amsmith1109/Low-Cost-Pirani-Gauge/Electronics/PCB Rear - Step 1.png

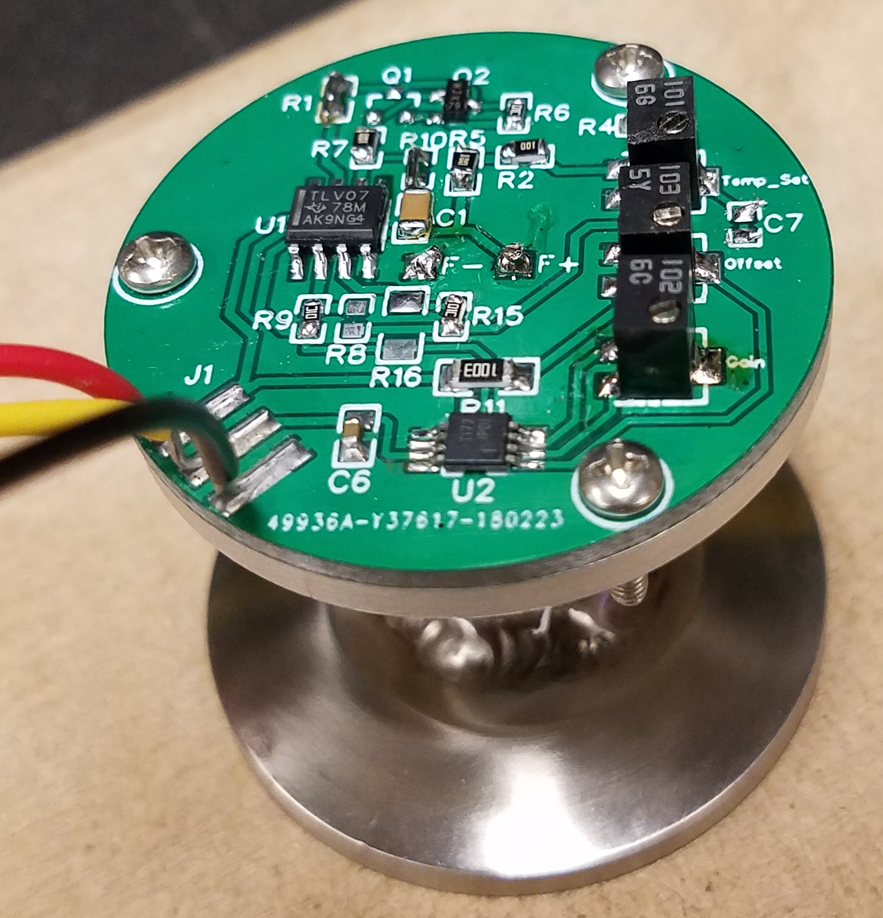
Electronics/PCB Rear - Step 1.png
