amsmith1109/Low-Cost-Pirani-Gauge/(list of files, cad)

Other CAD files:
3D Models (Inventor 2020)/Gauge/#22 o-ring.ipt
3D Models (Inventor 2020)/Gauge/2-56 1-2in length PHS.ipt
3D Models (Inventor 2020)/Gauge/4-40 1-4in length PHS.ipt
3D Models (Inventor 2020)/Gauge/Black 0603.ipt
3D Models (Inventor 2020)/Gauge/Black 0805.ipt
3D Models (Inventor 2020)/Gauge/Black 1206.ipt
3D Models (Inventor 2020)/Gauge/Board Spacer - 2.ipt
3D Models (Inventor 2020)/Gauge/Cap 0603.ipt
3D Models (Inventor 2020)/Gauge/Component1.ipt
3D Models (Inventor 2020)/Gauge/Component5(Mirror).ipt
3D Models (Inventor 2020)/Gauge/Component5.ipt
3D Models (Inventor 2020)/Gauge/Filament - updated.ipt
3D Models (Inventor 2020)/Gauge/Filament Board.iam
3D Models (Inventor 2020)/Gauge/Filament Board.ipt
3D Models (Inventor 2020)/Gauge/Housing - 3,2.ipt
3D Models (Inventor 2020)/Gauge/LED-0603H0.75.ipt
3D Models (Inventor 2020)/Gauge/Pirani Gauge.iam
3D Models (Inventor 2020)/Gauge/Power Supply Board.iam
3D Models (Inventor 2020)/Gauge/Power Supply.ipt
3D Models (Inventor 2020)/Gauge/RJ12 - Straight.ipt
3D Models (Inventor 2020)/Gauge/SM42W.ipt
3D Models (Inventor 2020)/Gauge/SOT-23 (TO-236).ipt
3D Models (Inventor 2020)/Gauge/SOT23.iam
3D Models (Inventor 2020)/Gauge/TO-252AA-Vishay.ipt
3D Models (Inventor 2020)/Gauge/Vacuum Housing - KF.ipt
3D Models (Inventor 2020)/Gauge/aluminumelectrolytic.ipt
3D Models (Inventor 2020)/Gauge/icbody.ipt
3D Models (Inventor 2020)/Gauge/pin.ipt
3D Models (Inventor 2020)/Gauge/sop127p-6mm-8 v2.iam
3D Models (Inventor 2020)/Readout/1 pin header.ipt
3D Models (Inventor 2020)/Readout/10 female pin.ipt
3D Models (Inventor 2020)/Readout/10 pin header.ipt
3D Models (Inventor 2020)/Readout/10_Micro USB-B SMD & pads.ipt
3D Models (Inventor 2020)/Readout/15 female pin.ipt
3D Models (Inventor 2020)/Readout/15 pin header - round.ipt
3D Models (Inventor 2020)/Readout/16 pin header.ipt
3D Models (Inventor 2020)/Readout/2 female pin.ipt
3D Models (Inventor 2020)/Readout/2x3 header.ipt
3D Models (Inventor 2020)/Readout/4 female pin.ipt
3D Models (Inventor 2020)/Readout/400nH Inductor.ipt
3D Models (Inventor 2020)/Readout/4x20 LCD.ipt
3D Models (Inventor 2020)/Readout/ADS1115.ipt
3D Models (Inventor 2020)/Readout/Arduino Nano - Soldered.iam
3D Models (Inventor 2020)/Readout/Arduino Nano.ipt
3D Models (Inventor 2020)/Readout/Black 0603 - Soldered.ipt
3D Models (Inventor 2020)/Readout/Black 0805.ipt
3D Models (Inventor 2020)/Readout/Black 1206 - Soldered.ipt
3D Models (Inventor 2020)/Readout/Boost Converter.iam
3D Models (Inventor 2020)/Readout/Boost Converter.ipt
3D Models (Inventor 2020)/Readout/Cap 0805.ipt
3D Models (Inventor 2020)/Readout/Clicker Switch.ipt
3D Models (Inventor 2020)/Readout/DO-221AC.ipt
3D Models (Inventor 2020)/Readout/Faceplate.ipt
3D Models (Inventor 2020)/Readout/Gauge Controller.iam
3D Models (Inventor 2020)/Readout/LED-0603H0.75 - Soldered.ipt
3D Models (Inventor 2020)/Readout/Male Header - 1X2Wht.ipt
3D Models (Inventor 2020)/Readout/Male Headers.ipt
3D Models (Inventor 2020)/Readout/MicroUSB Breakout.iam
3D Models (Inventor 2020)/Readout/MicroUSB.iam
3D Models (Inventor 2020)/Readout/OldVersions/4x20 LCD.0006.ipt
3D Models (Inventor 2020)/Readout/OldVersions/Base2.0001.ipt
3D Models (Inventor 2020)/Readout/OldVersions/Faceplate.0004.ipt
3D Models (Inventor 2020)/Readout/OldVersions/Faceplate.0028.ipt
3D Models (Inventor 2020)/Readout/OldVersions/Readout Cover.0005.ipt
3D Models (Inventor 2020)/Readout/OldVersions/Readout.0022.iam
3D Models (Inventor 2020)/Readout/PCB.ipt
3D Models (Inventor 2020)/Readout/PHS UNC.ipt
3D Models (Inventor 2020)/Readout/PHS UNC19.ipt
3D Models (Inventor 2020)/Readout/PHS UNC2.ipt
3D Models (Inventor 2020)/Readout/PHS UNC20.ipt
3D Models (Inventor 2020)/Readout/Precision Trim Pot - baoter 3296.ipt
3D Models (Inventor 2020)/Readout/RJ12 - 90deg.ipt
3D Models (Inventor 2020)/Readout/Readout Base.ipt
3D Models (Inventor 2020)/Readout/Readout Cover.ipt
3D Models (Inventor 2020)/Readout/Readout Wires.ipt
3D Models (Inventor 2020)/Readout/Readout.iam
3D Models (Inventor 2020)/Readout/SOT-23 6 pin.iam
3D Models (Inventor 2020)/Readout/SOT323-5L.ipt
3D Models (Inventor 2020)/Readout/Switch Nut.ipt
3D Models (Inventor 2020)/Readout/Switch.ipt
3D Models (Inventor 2020)/Readout/TO-243AA.ipt
3D Models (Inventor 2020)/Readout/USB-Mini-B.ipt
3D Models (Inventor 2020)/Readout/pcb_microusb.ipt
