amsmith1109/Low-Cost-Pirani-Gauge/Electronics/Pirani Gauge Schematics.pdf

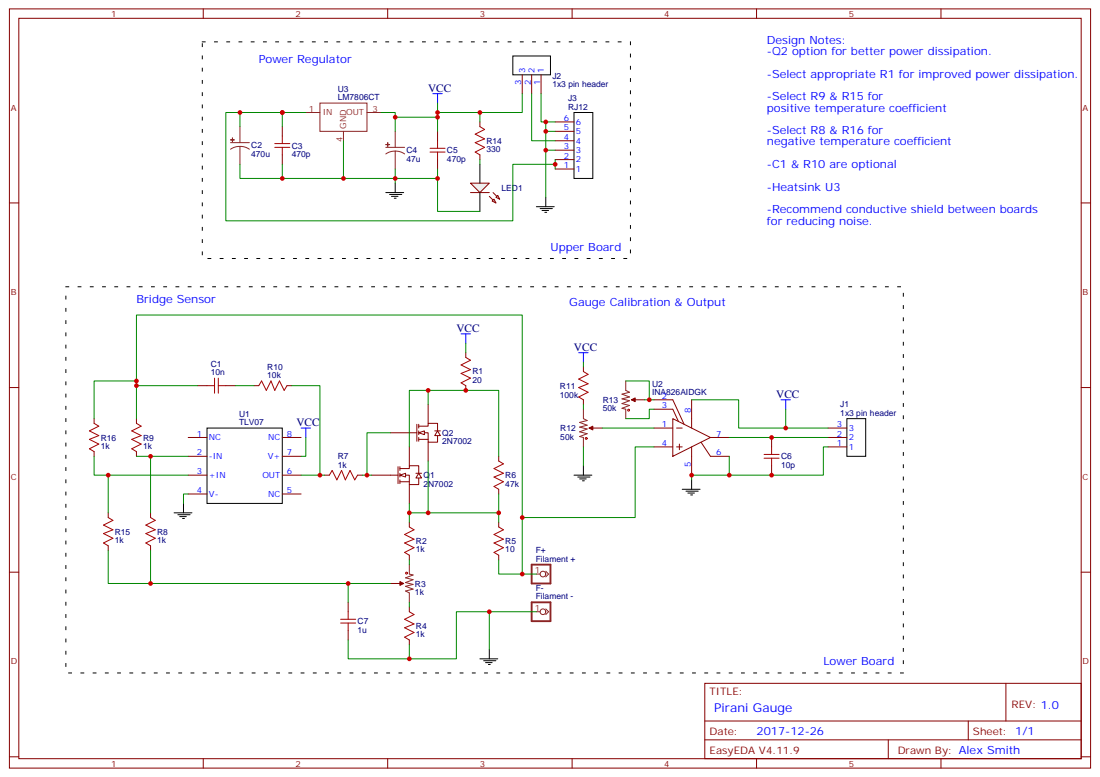
[picture p3: page 1]

Design Notes:
-Q2 option for better power dissipation.
-Select appropriate R1 for improved power dissipation.
-Select R9 & R15 for
positive temperature coefficient
-Select R8 & R16 for
negative temperature coefficient
-C1 & R10 are optional
-Heatsink U3
-Recommend conductive shield between boards
for reducing noise.
