amsmith1109/Low-Cost-Pirani-Gauge/Electronics/Arduino DAC Schematic.pdf

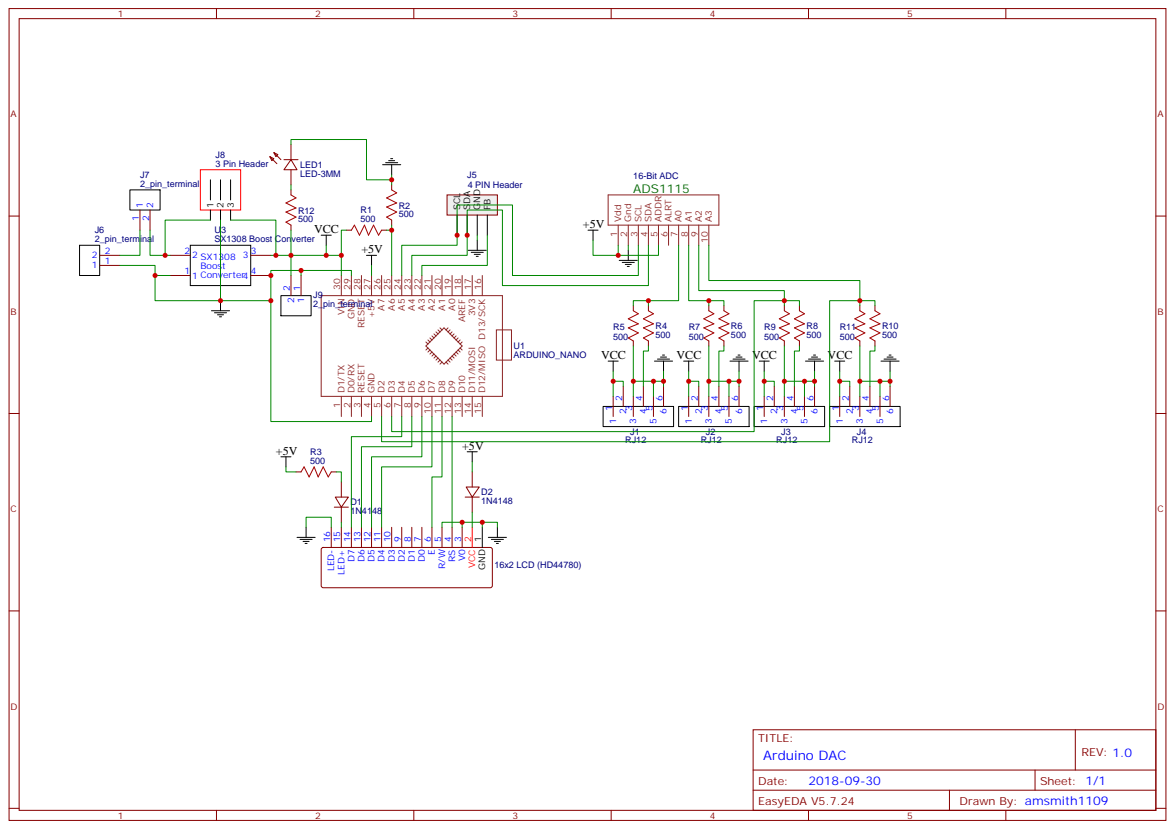
[picture p4: page 1]
