amsmith1109/Low-Cost-Pirani-Gauge/(commit log)

2020-04-16 Creation of Repository
    Initial creation that includes matlab source code, arduino code, and the inventor 3D models.
    [#22 o-ring.ipt, 08-18-2019 Glass Bead - A - gain & binary (mbar) - Original.csv, 08-18-2019 Glass Bead - A - gain & binary (mbar).csv, 08-18-2019 Glass Bead - A.csv, 08-18-2019 Glass Bead - B - no error (scaled & mbar).csv, 08-18-2019 Glass Bead - B - no error.csv, 08-18-2019 Glass Bead - B.csv, 1 pin header.ipt]
2020-04-16 Arduino Added
2020-04-16 Electronics Schematics and Gerber Files
2021-02-01 Delete [draft] A low-cost and open source Pirani-style vacuum gauge sensor and readout.docx
    Need to get an okay to actually upload this.
2022-07-27 Add Assembly Photos
